deSales327/corne-x/corne-x.kicad_pcb

## KiCad design corne-x.kicad_pcb (2026-11-02)

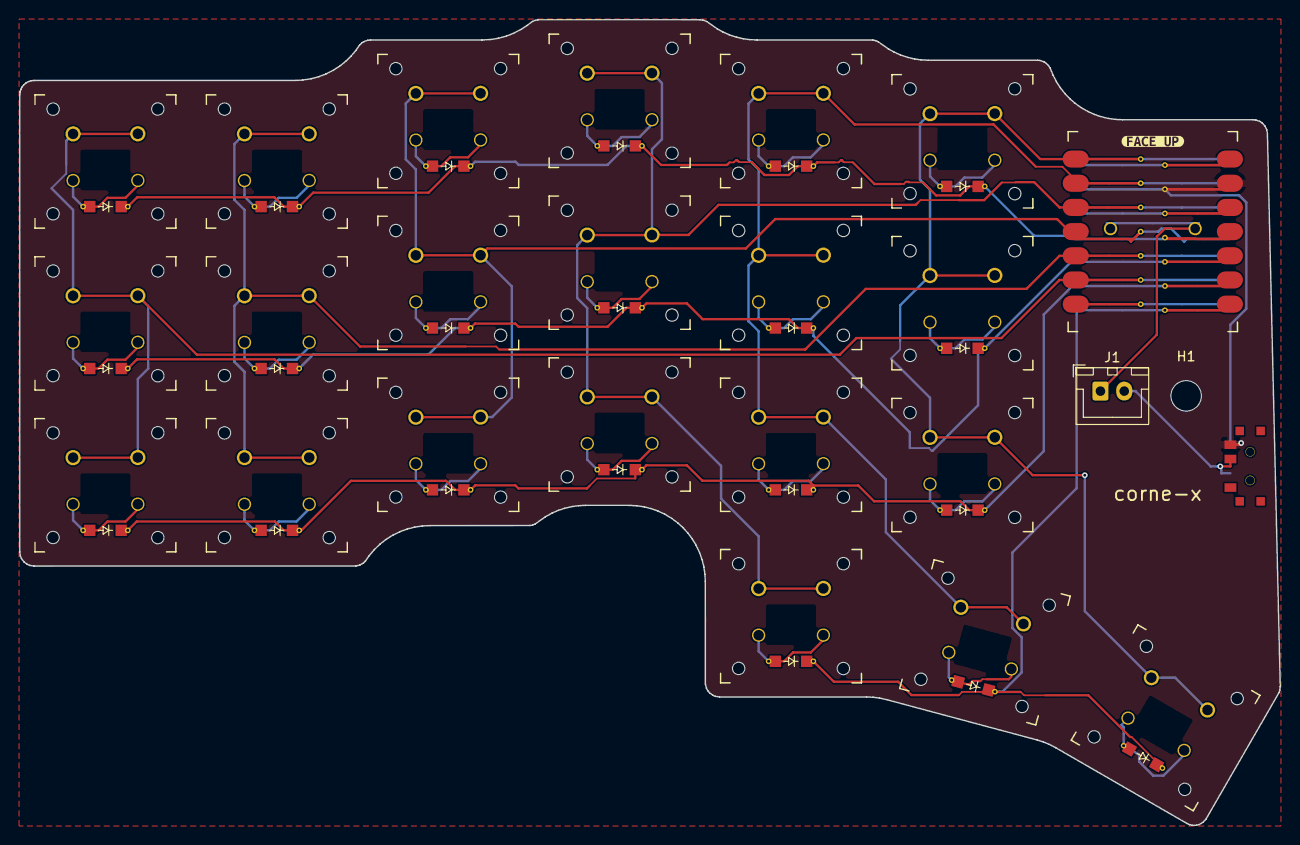
[picture p4: board corne-x.kicad_pcb from above]

Board: 2 copper layers, 132.4 x 84.6 mm, 47 parts (1 on the bottom side), 34 nets.

Parts:
D1, D2, D3, D4, D5, D6, D7, D8, D9, D10, D11, D12, D13, D14, D15, D16, D17, D18, D19, D20, D21: ComboDiode
H1: MountingHole_3.2mm_M3
J1: JST_XH_B2B-XH-A_1x02_P2.50mm_Vertical
PWR1, PWR1#2: SPDT_C128955
S1, S2, S3, S4, S5, S6, S7, S8, S9, S10, S11, S12, S13, S14, S15, S16, S17, S18, S19, S20, S21: Kailh-PG1425-X-Switch-revers
XIAO1: xiao-rev

Connections:
BAT: J1.1, XIAO1.19
BAT-: J1.2, PWR1.2, PWR1#2.2
GND: PWR1.3, PWR1#2.1, XIAO1.13
c0: S1.1, S2.1, S3.1, XIAO1.6
c1: S4.1, S5.1, S6.1, XIAO1.5
c2: S7.1, S8.1, S9.1, XIAO1.4
c3: S10.1, S11.1, S12.1, S19.1, XIAO1.3
c4: S13.1, S14.1, S15.1, S20.1, XIAO1.2
c5: S16.1, S17.1, S18.1, S21.1, XIAO1.1
k_c0_r1: D3.2, S3.2
k_c0_r2: D2.2, S2.2
k_c0_r3: D1.2, S1.2
k_c1_r1: D6.2, S6.2
k_c1_r2: D5.2, S5.2
k_c1_r3: D4.2, S4.2
k_c2_r1: D9.2, S9.2
k_c2_r2: D8.2, S8.2
k_c2_r3: D7.2, S7.2
k_c3_r0: D19.2, S19.2
k_c3_r1: D12.2, S12.2
k_c3_r2: D11.2, S11.2
k_c3_r3: D10.2, S10.2
k_c4_r0: D20.2, S20.2
k_c4_r1: D15.2, S15.2
k_c4_r2: D14.2, S14.2
k_c4_r3: D13.2, S13.2
k_c5_r0: D21.2, S21.2
k_c5_r1: D18.2, S18.2
k_c5_r2: D17.2, S17.2
k_c5_r3: D16.2, S16.2
r0: D19.1, D20.1, D21.1, XIAO1.8
r1: D3.1, D6.1, D9.1, D12.1, D15.1, D18.1, XIAO1.9
r2: D2.1, D5.1, D8.1, D11.1, D14.1, D17.1, XIAO1.10
r3: D1.1, D4.1, D7.1, D10.1, D13.1, D16.1, XIAO1.11
