deSales327/corne-x/(commit log)

2026-11-02 PCB corne-x: Corne com switches Kailh X baseado no dust
    PCB reversível 3x6+3 (42 teclas) com os footprints do dust
    (Kailh X PG1425, XIAO reversível, TRRS, bateria), gerador em
    Python, preview da matriz e mockup montado.
    [corne-x.kicad_pcb]
2026-11-02 Versão sem fios: JST-XH, furo para a bateria, pistas e gerbers
    - Remove o TRRS e o JST-SH; acrescenta JST-XH 2,50 mm (J1) e furo
    de 3,2 mm (H1) ao lado do XIAO para os fios da bateria
    - finalizar_pcb.py: roteia com o Freerouting, plano de GND, DRC
    (0 violações) e exporta gerbers/furação
    - As duas cópias do interruptor deixam de duplicar os furos
    - Mockup atualizado para XIAO nRF52840 e renders 3D do KiCad
    [corne-x.kicad_pcb]
